dormeneur/FireResQ/(commit log)

2026-09-20 feat: complete simulation navigation and phase 4
    Phases 1-4 of the FireResQ implementation plan, verified together from a clean
    rebuild: 131 passed, 1 xfailed (unit + simulation + slow tiers).
    Phase 1 - workspace and robot description
    - ten ROS 2 packages; custom interfaces; reusable 2WD + caster description
    - all robot dimensions and drive limits live in parameters.xacro
    Phase 2 - simulation foundation
    - Gazebo diff drive, joint states, odometry, RGB + depth cameras via ros_gz_bridge
    - fixes found by comparing against ground truth: robot resting on its magnet,
    base_link not at the axle midpoint, wheel-contact over-rotation
    Phase 3 - rescue arena
    - deterministic 5x5 m arena generated fr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
    [base.xacro, empty_world.sdf, fire_resq.urdf.xacro, fire_resq_gazebo.urdf.xacro, gz_drive.xacro, gz_sensors.xacro, inertia.xacro, magnet.xacro]
2026-09-20 feat: complete perception pipeline
    Phase 5: fire and victims are detected by colour and placed in a TF frame on
    /fire_resq/detections, from depth (RGB-D) or from object-height priors
    (RGB-only), through one message type.
    - fire_resq_perception: ColorBlobDetector, DepthEstimator, KnownHeightEstimator
    (top-edge anchor; the planned ground-plane method measured 13-57 cm off),
    MotionGate (no positions while the camera turns: RGB/depth/TF are offset in
    time), PerceptionPipeline, single-threaded perception_node, config, launch.
    - fire_resq_description: small Python reader of parameters.xacro so the floor
    offset is never restated (shared with navigation).
    - arena.launch.py / arena_nav.launc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
2026-09-20 feat: complete world model
    Phase 6: a persistent belief about the fire, the victims, their status and the
    safe zone, published in the map frame on /fire_resq/world_state.
    - fire_resq_world_model: ROS-free WorldModel library (association by nearest
    neighbour in a gate, EMA positions, confidence decayed with time unseen,
    tentative UNKNOWN -> DETECTED confirmation, ghost expiry, victim status
    lifecycle with a terminal RESCUED, one active target, safe-zone rule) plus a
    thin world_model_node, config, launch, and RViz marker descriptions.
    - UpdateVictimStatus service is the only way rescue code changes a status.
    - arena_nav.launch.py: opt-in world_model:=true; navigation.rviz shows the ma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
2026-09-21 feat: implement cognitive victim prioritization
    Cognition (plan Phase 8, built before Phase 7 on request): the robot decides which
    victim to rescue next from its current world model, with the real Nav2 planner
    supplying path lengths and reachability, and every decision explains itself.
    - fire_resq_cognition: ROS-free VictimPrioritizer library (WeightedUtilityPrioritizer,
    the MVP; NearestVictimPrioritizer, the PRD baseline), configurable weights, explicit
    eligibility (unreachable / planner-unknown / wrong status are excluded with reasons,
    never silently selected), a Nav2 path-query adapter that only asks the planner, and a
    single-threaded prioritizer_node: /fire_resq/rescue_target, /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
    [prioritizer.yaml]
2026-09-22 feat(cognition): complete prioritization and nav reliability
    Plan Phase 7 (Nav2 reliability + path-query helper), on top of the
    already-accepted cognition work (b82a165).
    Root cause and fix:
    - The Regulated Pure Pursuit controller's own `stateful` (default true)
    latched "arrived" the first cycle it was inside the goal checker's xy
    tolerance, then only rotated in place; the checker needed its own,
    later evaluation of the same tolerance, so a sub-centimetre gap froze
    the robot until the progress checker aborted (measured: 44% of G1,
    12% of the detour goal G2 failed). Fix: `FollowPath.stateful: false`
    in nav2_params.yaml; the goal checker's own latch is unaffected.
    Measured after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
    [prioritizer.yaml]
2026-09-23 feat(control): add electromagnet abstraction
    Phase 9: the electromagnet can be commanded ATTACH/RELEASE through one
    hardware-neutral interface, and in simulation it genuinely picks a
    victim up - verified against Gazebo's own physics, not just a service
    response.
    Interface (SetMagnet, MagnetState) reused exactly as already defined;
    one comment added to MagnetState.victim_id clarifying it is provenance
    only (Gazebo's model name in sim), never a world-model id - same
    convention as Detection.source_backend.
    Where the abstraction lives:
    magnet_node (fire_resq_control, hardware-neutral)
    -- SetMagnet --> RosTopicMagnetBackend
    -- /fire_resq/magnet/energize (Bool) -->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
    [fire_resq_gazebo.urdf.xacro, gz_magnet.xacro]
2026-10-06 feat(planning): autonomous rescue loop (Phase 10)
    An explicit, deterministic rescue FSM runs the whole mission unattended
    from a cold start: perceive, let cognition choose (SelectTarget only),
    Nav2 to the approach pose, ALIGN into magnet contact, attach, verify the
    carry, carry to the safe zone, release, verify, mark RESCUED, reassess,
    and a coverage search of the saved map for victims not yet seen.
    - fire_resq_planning: RescueFSM (pure, no clock/ROS, declared
    transitions), geometry, coverage SEARCH, rescue_node (ROS glue,
    /fire_resq/mission_state, ExecuteRescue). No new interface.
    - Trusts sensors, never requests: attached = the magnet's state plus
    identity by geometry; rescued = rel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
2026-10-06 docs: quick-start guides for the simulation and the real robot
    - HOW_TO_RUN_THE_COMPLETE_SIMULATION.md: install, build, map, run the
    full rescue mission, watch it, test it, troubleshoot.
    - HOW_TO_MAKE_THE_COMPLETE_ROBOT.md: status, parts, wiring tables,
    bench test, camera demo with the real perception node, and the steps
    to full autonomy (Phase 12 bridge still to be written).
    - src/fire_resq_hardware/firmware/bench_test: ESP32 serial bench test
    (drive + magnet pin with an LED stand-in, 1 s auto-stop). Not the
    Phase 12 firmware.
2026-10-20 Add firmware for WANDER BOT with motor control and sonar functionality
    - Implemented Arduino firmware for controlling the WANDER BOT using the Adafruit Motor Shield v1.
    - Added functions for motor control, servo movement, and sonar distance measurement.
    - Included command parsing for motor speed adjustments and servo positioning.
    - Integrated a watchdog mechanism to release motors after a timeout.
    - Established serial communication for command input and feedback.
2026-10-20 feat(robot): robust fire-first rescue mission for the Pi robot
    Final version of robot/rescue_bot.py for the real Pi 3B + Uno robot: survey,
    rank the yellow-wheel victims by distance to the red-box fire, then for each in
    that order drive right up to it and back to the start.
    Depth and ordering:
    - floor-plane ranging from the image row (hub centre / box base), documented
    - victim-to-fire distances measured within the same photo, so pose and
    heading errors cancel; medians over 3 frames x several views
    - clustering: two blobs in one photo are two objects; range tolerance grows
    with range^2 so one far wheel is not split
    - identity by bearing AND range (unlikeness), for homing and the re-chec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
2026-10-21 feat(robot): fire-first rescue rounds with floor-based detection
    Rework robot/rescue_bot.py for the new arena: a tan cardboard box is the
    fire and the victims are wheels lying flat, all in view from the start.
    - detection measured in this room: a flat wheel is a pale-yellow rim on a
    black tyre band ending on bright floor (fallback: a dark puck on the
    floor); the fire is the largest tan blob standing on the floor, using
    its base only (a chair behind it no longer skews it)
    - "closest to the fire" = distance to the box's base EDGE, measured in
    the same photo, median over 6 photos; specks seen once are ignored
    - no turning survey: each round looks, picks the closest victim to the
    fire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
2026-10-21 fix(robot): a new run stops a forgotten earlier copy holding the camera
    Starting rescue_bot.py while an earlier --plan/--view copy still ran failed
    with 'camera busy'. It now stops any earlier python copy of itself first
    (only python processes, never the shell or timeout that launched one), and
    says plainly when another program (targetfire) holds the camera.
2026-10-21 fix(robot): pivot turns, stop-and-go homing, sturdier fire detection
    From the first real drive and a 1 s/turn measurement on the tile floor:
    - an arc (one side full, the other half) turned the robot 1.7 deg; a pivot
    (one side drives, the other stops) turned it 13-19 deg. Turns are now
    forward/backward pivots of opposite sides (same rotation, creep cancels)
    - homing lost the victim while driving: in this light motion blur erases
    the thin yellow rim. Homing is now stop-and-go: still picture, face it,
    hop <= 20 cm, repeat; the final touch skips the fire stop
    - the fire picked an orange cushion (hue 11) and missed the box (shadow
    under its base failed the bright-floor test): tan hue no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
2026-10-21 test(robot): motion_test.py - one move at a time, with the turn the camera measured
2026-10-21 feat(robot): skid-spin turns and strong-motor trim (M2, M4)
    On the maintainer's instruction: pivots swing the big chassis round a
    corner, so turns are differential skid spins (one side forward, the other
    backward) about the centre. M2 and M4 are the strong motors and are scaled
    to 85% so all four match.
2026-10-21 fix(robot): centre-then-go homing, measured skid turns, homing obstacle limit
    Review of detect -> decide -> plan -> move:
    - turns: pulse, STOP, measure what the camera says the robot really turned,
    learn the rate, pulse again for the rest (each pulse aims 80% of what is
    left; at least 0.15 s so a skid spin breaks the tyres loose). The old
    'stop 4 deg early' gave 60 ms pulses for small corrections, too short to
    move the robot, and could declare the motors dead
    - homing: turn until the victim is within 4 deg of the picture centre (on a
    still picture), only then drive a hop straight at it; after an overshot
    turn the search window widens again
    - homing hops only stop for a sonar echo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
2026-10-21 fix(robot): sturdier detection for both arenas (tan box or red bag, flat or standing wheels)
    From live frames on 2026-10-22:
    - fire: tan OR red, base found by walking down through glare/shadow to the
    floor, width from the widest row; brightness floor V 52 keeps the curtain
    and chair out, the hue range keeps the orange cushion out
    - standing wheels: round yellow hub over a black tyre, range from the hub
    centre (one wheel radius up) - the floor reflection fooled the walk-down
    - flat wheels: pucks must be truly black (V<30) so the box shadow does not
    join them, the floor test tolerates the glossy reflection, and a hint of
    yellow hub must sit above (cushion shadows have red/orange ther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
2026-10-21 fix(robot): turns that cannot stall on a weak side
    The mission's first turn (-6 deg, to the right) "did not turn the robot":
    measured just after, a 1 s full-power spin turned it +23.6 deg left but
    only -7.8 deg right, so its 0.18 s right pulses barely moved it.
    - minimum spin pulse 0.3 s (from 0.15)
    - spin rate learned separately for left and right
    - after two pulses that do not turn it, a short nudge forward and back
    first (rolling tyres slip round far more easily than stuck ones)
    - every pulse is logged with its length and the rotation measured; 8
    failed pulses (from 6) before giving up, with a clearer message
2026-10-21 feat(robot): continuous rescue from the safe area; close-range loss counts as reached
    - the mission never finishes on its own: it watches the arena from the safe
    area (the start) every 2 s, rescues the victim closest to the fire as
    soon as one is in view, returns, waits for it to be taken out, watches
    again. Victims can be added at any time; a new victim on an old spot is
    new; names stay stable between looks (A..Z, AA, ...)
    - up close the wheel drops out of the camera's view: a victim last seen
    within 45 cm that then disappears is right in front - creep the rest and
    count it as reached ("RESCUED"), then "SAVED" back at the safe area.
    A victim lost from further away is retried,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
2026-10-21 fix(robot): dashboard reachable over IPv6 too, and its IP printed
    The user's PC resolves pi.local to the Pi's IPv6 address, but the dashboard
    listened on IPv4 only, so the browser was refused. It now listens on both,
    and the start-up line also prints http://<the Pi's IPv4>:8090 as a fallback.
2026-10-27 feat: quick Gazebo demo, restored victimbot, demo-day notes
    - run_sim.sh + quick_demo/: a small random 3x3 m arena (one fire, three
    victims); the robot ranks the victims by perceived distance to the fire
    and carries them to the safe zone closest-first. Real perception and
    magnet, odometry driving, no Nav2/SLAM. Verified against Gazebo truth
    on seeds 1-5 (~100 s per mission, RTF 1.0).
    - simulation/worlds/demo_world.sdf and an arena.launch.py base_world arg.
    - victimbot/ restored from hardware-bringup-and-demo, with fixes found on
    the real robot: the horizon is always re-measured from the victims (the
    stored row was stale after the camera tilted, giving ~0.22 m for ~1 m);
    the son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
